TheSmaszer/b-parasite/kicad/production/bom.csv

Designator | Footprint | Quantity | Value | LCSC Part #
BT1 | BatteryHolder_Keystone_3002_1x2032 | 1 | Battery_Cell
C1 | 0402 | 1 | 1n | C1523
C2 | 0402 | 1 | 100n | C1525
C3, C4 | 0402 | 2 | 12p | C1547
D1 | D_MiniMELF | 1 | LL4148 | C3011166
D2 | 0603 | 1 | LED | C2286
Q1 | SOT-23 | 1 | MMBT3906 | C2910191
Q4 | TR8 | 1 | Q_Photo_NPN | C146233
R1, R4, R7, R8 | 0402 | 4 | 10k | C25744
R10 | 0402 | 1 | 470 | C25117
R2 | 0402 | 1 | 1k | C11702
R6 | 0402 | 1 | 1M | C26083
RST1, SW1 | SW_B3U-1000P | 2 | B3U-1000P | C231329
U1 | E73-2G4M08S1C | 1 | E73-2G4M08S1C | C356849
U2 | Sensirion_DFN-4_1.5x1.5mm_P0.8mm_SHT4x_NoCentralPad | 1 | SHT4x
Y1 | Crystal_SMD_3215-2Pin_3.2x1.5mm | 1 | 32.768kHz | C32346
