TheSmaszer/b-parasite/kicad/parasite.csv

Id | Designator | Footprint | Quantity | Designation | Supplier and ref
1 | BT1 | BatteryHolder_Keystone_3002_1x2032 | 1 | Battery_Cell
2 | C1 | C_0402_1005Metric | 1 | 1n
3 | C2 | C_0402_1005Metric | 1 | 100n
4 | C3, C4 | C_0402_1005Metric | 2 | 12p
5 | D1 | D_MiniMELF | 1 | LL4148
6 | D2 | LED_0603_1608Metric | 1 | LED
7 | Q1 | SOT-23 | 1 | MMBT3906
8 | Q4 | TR8 | 1 | Q_Photo_NPN
9 | R1, R4, R7, R8 | R_0402_1005Metric | 4 | 10k
10 | R2 | R_0402_1005Metric | 1 | 1k
11 | R6 | R_0402_1005Metric | 1 | 1M
12 | R10 | R_0402_1005Metric | 1 | 470
13 | RST1, SW1 | SW_B3U-1000P | 2 | B3U-1000P
14 | U1 | E73-2G4M08S1C | 1 | E73-2G4M08S1C
15 | U2 | Sensirion_DFN-4_1.5x1.5mm_P0.8mm_SHT4x_NoCentralPad | 1 | SHT4x
16 | Y1 | Crystal_SMD_3215-2Pin_3.2x1.5mm | 1 | 32.768kHz
