TheSmaszer/b-parasite/code/prstlib/src/sensors.c

#include "prstlib/sensors.h"

#include <zephyr/logging/log.h>

#include "prstlib/adc.h"
#include "prstlib/led.h"
#include "prstlib/macros.h"

LOG_MODULE_REGISTER(sensors, CONFIG_PRSTLIB_LOG_LEVEL);

int prst_sensors_read_all(prst_sensors_t *sensors) {
  RET_IF_ERR(prst_adc_batt_read(&sensors->batt));
  RET_IF_ERR(prst_adc_soil_read(sensors->batt.adc_read.voltage, &sensors->soil));
  RET_IF_ERR(prst_adc_photo_read(sensors->batt.adc_read.voltage, &sensors->photo));
  RET_IF_ERR(prst_shtc4_read(&sensors->shtc4))

  LOG_INF("Batt: %d mV (%.2f%%)", sensors->batt.adc_read.millivolts,
          DOUBLE_PROMO_OK(100 * sensors->batt.percentage));
  LOG_INF("Soil: %.0f %%", DOUBLE_PROMO_OK(100 * sensors->soil.percentage));
  LOG_INF("Photo: %u lx (%d mV)", sensors->photo.brightness,
          sensors->photo.adc_read.millivolts);
  LOG_INF("Temp: %f oC", DOUBLE_PROMO_OK(sensors->shtc4.temp_c));
  LOG_INF("Humi: %.0f %%", DOUBLE_PROMO_OK(100 * sensors->shtc4.rel_humi));
  LOG_INF("--------------------------------------------------");

  return 0;
}
