TheSmaszer/b-parasite/(commit log)

2026-10-26 replaced sht3 for sht4
    [main.c, sensors.c, shtc4.c]
2026-10-26 added sht4 in the devicetree
2026-10-26 modified PCB design for SHT4
    [parasite-B_Cu.gbl, parasite-B_Cu.gbr, parasite-B_Mask.gbr, parasite-B_Mask.gbs, parasite-B_Paste.gbp, parasite-B_Paste.gbr, parasite-B_Silkscreen.gbo, parasite-B_Silkscreen.gbr]
2026-10-26 production for JLC PCB
    [bom.csv, designators.csv, positions.csv]
